gumbini/strontiumaluminatdisplay/schematic.jpg

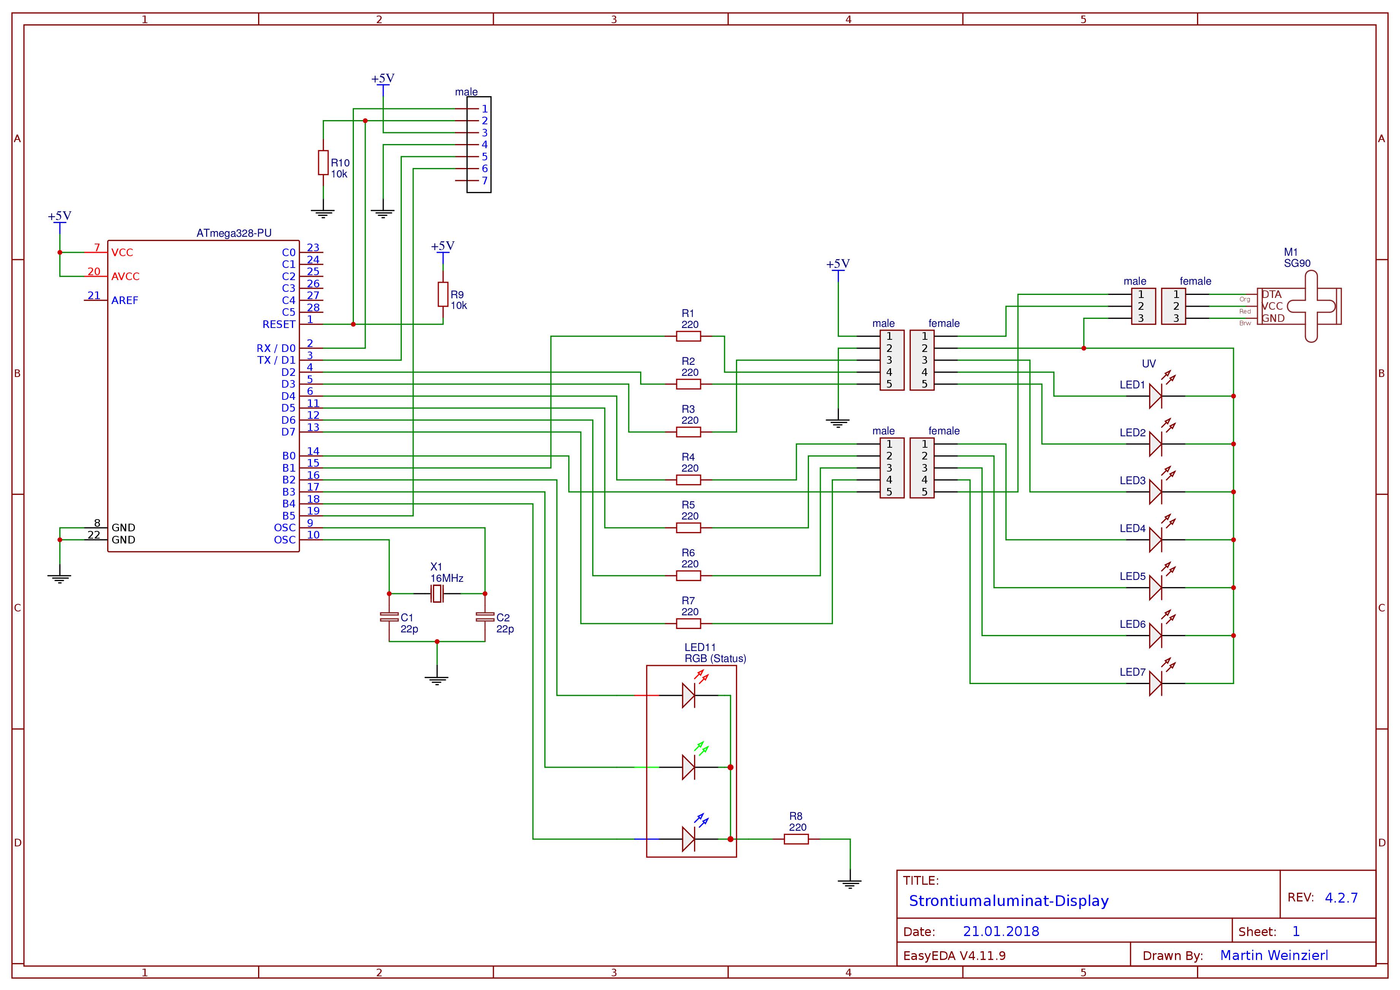
schematic.jpg
