gumbini/strontiumaluminatdisplay/schematic.pdf

+5V

+5V

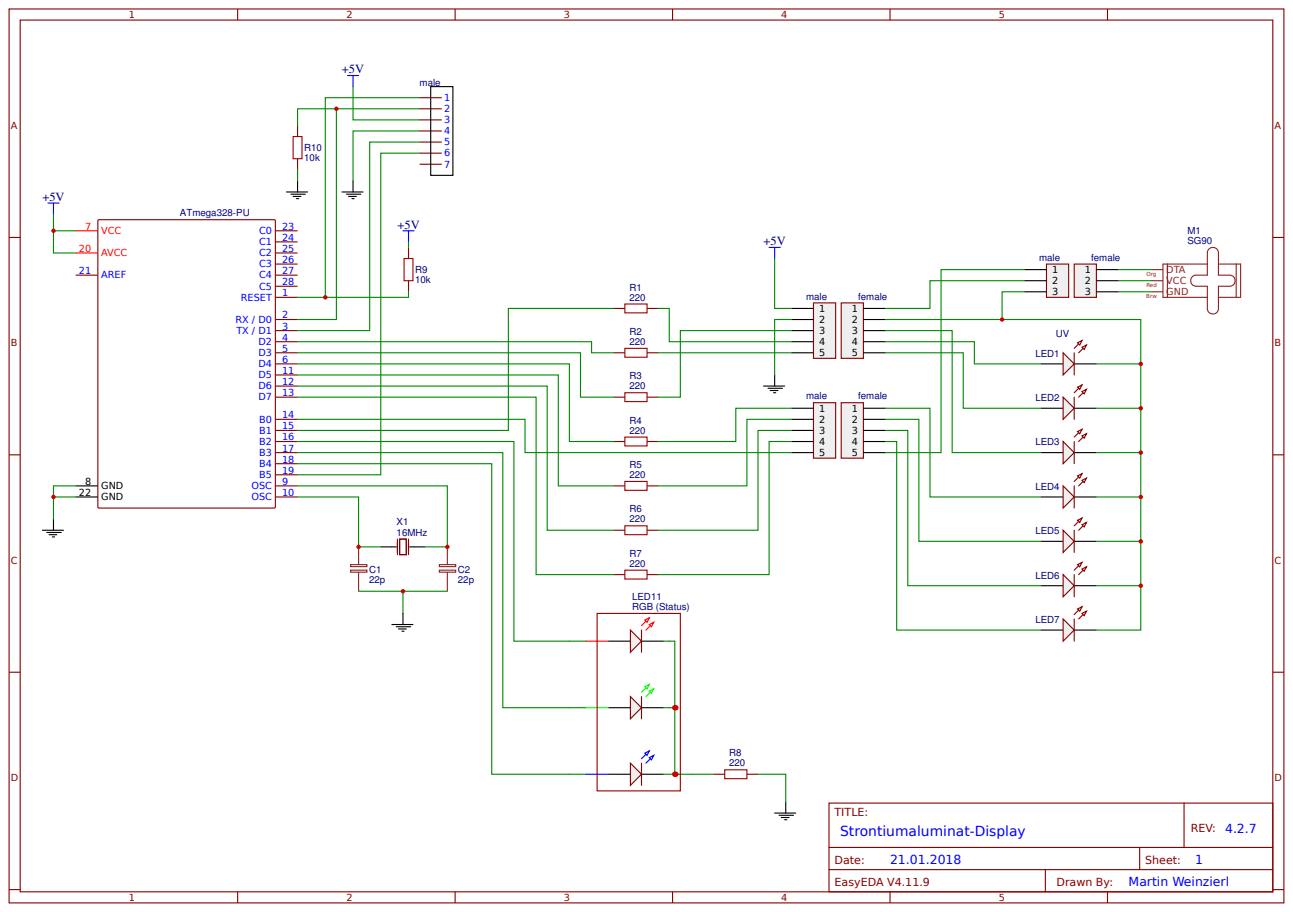
[picture p6: page 1]
